dDenVil/LightBot/Readme_assets/buttons.png

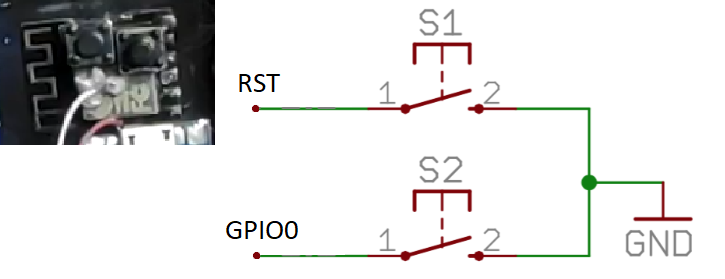
Readme_assets/buttons.png
