dDenVil/LightBot/Readme_assets/telegram.png

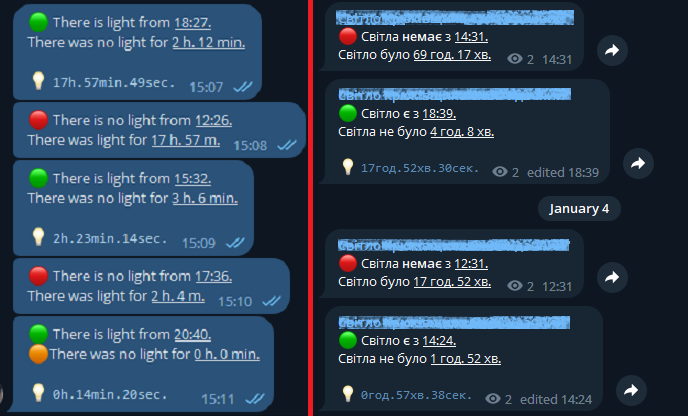
Readme_assets/telegram.png
