dDenVil/LightBot/(commit log)

2023-05-27 Update Code.txt
    delay(5000); // if power off was for 5sec, neglect it
2023-10-28 Update README.md
    https://arduino.esp8266.com/stable/package_esp8266com_index.json
